P-sorawit/Circuit-Project-Smart-Home-/Report.pdf

Smart Home ปู้นปู้นเวรี่ย

์ปู้นปู้นสลดิปิ้ดปั๊ด

โดย

นายภัทรวิน ยอดสุขา รหัสนักศึกษา 67010699

นายภาคิน โพธิจรรยากุล รหัสนักศึกษา 67010705 นายวิริทธิ์พลรอดเงิน รหัสนักศึกษา 67010848

นายสรวิศ เพชรพบิูลย์ไทย รหัสนักศึกษา 67010926

รายงานฉบับนี้เป็ นส่วนหนึ่งของการศึกษาในรายวิชา 01076107 Circuits and Electronicsและ01076108 Circuits and Electronics in Practice สาขาวิศวกรรมคอมพิวเตอร์ ภาควิชาวิศวกรรมคอมพิวเตอร์ คณะวิศวกรรมศาสตร์
สถาบันเทคโนโลยีพระจอมเกล้าเจ้าคุณทหารลาดกระบัง ปี การศึกษา 2567

### บทที่1 บทน า และหลักการ

### 1.1 แนวคิดและที่มาของปัญหา

ปัจจุบันเทคโนโลยีมีการพัฒนาอย่างรวดเร็ว ส่งผลให้เทคโนโลยีสมาร์ทโฮมหรือบ้านอัจฉริยะได้รับ ความนิยมมากข้ึน เนื่องจากสามารถเพิ่มความสะดวกสบายและสร้างการใช้พลังงานอย่างมีประสิทธิภาพ หนึ่ง ในปัญหาหลักที่พบคือ การที่ไม่สามารถตรวจสอบอุปกรณ์เครื่องใชไ้ฟฟ้าภายในบา้นวา่ ใชง้านอยู่หรือไม่อีกท้งั การจอดรถในพ้ืนที่โรงรถ ที่มีพ้ืนที่จา กัดอาจทา ให้เกิดอุบตัิเหตุ เช่น การเฉี่ยวชนก าแพง สุดท้ายปัญหาการ จัดการอุณหภูมิภายในบ้านที่ต้องมีการระบายความร้อนเมื่ออุณหภูมิสูงเกินไปอย่างมีประสิทธิภาพ
โครงงาน "โมเดลจ าลองบ้านอัจฉริยะ" จึงถูกพฒั นาข้ึนเพื่อน าเสนอแนวทางในการแก้ไขปัญหา เหล่าน้ีโดยการบูรณาการเทคโนโลยีและระบบอัตโนมัติเข้ากับบ้านพกัอาศัยเพื่อเพิ่มความสะดวกสบาย ความปลอดภัย และความประหยัดพลังงาน โดยมีฟังก์ชันการท างานหลัก คือการควบคุมการเปิ ด-ปิดไฟร้ัวบา้น ด้วยรีโมท ระบบไฟที่เปิดปิดไฟร้ัวบา้นตามความเขม้แสงของสภาพแวดลอ้ มบา้น ระบบแจ้งเตือนใกล้ชนในที่ จอดรถการใช้เซ็นเซอร์วัดอุณหภูมิภายในบ้านเพื่อระบายความร้อนโดยพัดลม และระบบการแตะแผ่นเซ็นเซอร์ เพื่อเปิ ดไฟภายในบ้าน ซึ่งหลักการที่เกี่ยวข้องกับการสร้างโมดูลต่างๆในวงจรคือวงจรขยายสัญญาณและวงจร เปรียบเทียบ เพื่อเพิ่มขนาดของแรงดนัและเปรียบเทียบแรงดัน เพื่อให้สัญญาณจากเซ็นเซอร์สามารถอ่านค่าได้ ง่ายข้ึน โดยมีการใช้ออปแอมป์ เป็ นอุปกรณ์หลักในการสร้าง ดังต่อไปน้ีโมดูลเซ็นเซอร์วัดอุณหภูมิโมดูล วัดแสง(LDR) โมดูล Touch SensorโมดูลIR Remote และโมดูล IR Detect Car ผลลัพธ์จากโครงงานน้ีจะสามารถช่วยเพิ่มประสิทธิภาพในการบริหารจดัการบา้น ลดการใช้พลังงาน อย่างไม่จ าเป็ น เพิ่มความปลอดภยั และอา นวยความสะดวกให้แก่ผใู้ชง้านไดด้ีและเป็ นแบบอย่างต้นแบบให้กับ ผู้ที่สนใจเทคโนโลยีบ้านอัจฉริยะได้น าไปเป็ นแบบอย่างศึกษาต่อได้

### 1.2 วัตถุประสงค

์
1. เพื่อออกแบบและพัฒนาเซ็นเซอร์วัดอุณหภูมิโดยอัตโนมัติ
2. เพื่อออกแบบและพฒั นาเซ็นเซอร์วดัแสงเพื่อเปิดไฟร้ัวบา้นโดยอตัโนมตัิ
3. เพื่อออกแบบและพัฒนาเซ็นเซอร์ตรวจจับรถในโรงรถโดยอัตโนมัติ
4. เพื่อออกแบบและพัฒนา Touch Sensor ใช้ในการเปิ ดไฟ
5. เพื่อออกแบบและพัฒนารีโมทส่งคลื่น Infrared
6. เพื่อเป็ นต้นแบบของการพัฒนาบ้านอัจฉริยะ

### 1.3 หลักการท างานของโครงงาน

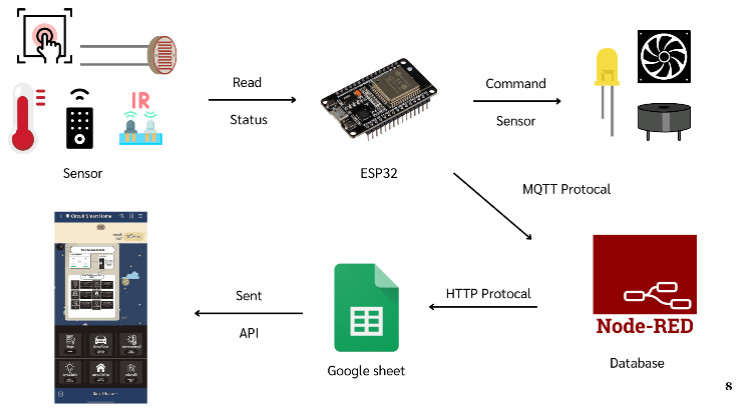
[picture p1: figure]

รูปที่ 1.1 แสดงภาพรวมการท างานของวงจร โครงงานประกอบไปด้วยเซ็นเซอร์ที่ท าหน้าที่เป็ น Input ท้งัหมด 5 ตวั ไดแ้ก่ LDR, Touch sensor, NTC Thermistor, IR Receiver (จากรีโมท)และIR Receiver (จากโรงรถ) มี Output 3 ชนิด ไดแ้ก่ หลอด LED, พัดลม และBuzzer โดย เมื่อแรงดันไฟฟ้ าผ่านวงจรเปรียบเทียบและวงจรขยายสัญญาณของ Op-Amp จะสั่งงาน เปิ ดพัดลมและหลอด LED โดยอัตโนมัติ เมื่อ ESP32อ่านค่าเซ็นเซอร์ที่รับมา จะพิจารณาสั่งการเปิด/ปิดไฟ และ Buzzer จากน้ันจะส่งขอ้ มูลค่า Input ที่อ่านได้ไปยัง Node-Red (เป็ น Protocol ตัวกลางส่งข้อมูลระหว่าง Node-Red กับ Google Sheet) ด้วย MQTT Protocol เมื่อ Node-Red ได้รับค่าจาก ESP32จะผ่านฟังก์ชันเปลี่ยนค่าที่ได้ รับมาให้เป็ นตัวแปรที่เหมาะสมต่อการแสดงผลบน Google Sheet จากน้ันเมื่อผูใ้ช้ตอ้งการทราบค่าเซ็นเซอร์ ต่างๆในบา้นโดยการกดขอขอ้ มูลในไลน์บอท ที่มีบอทน้อยทา งานอยู่เบ้ืองหลงั บอทน้อยจะส่ง APIขอข้อมูล จาก Google Sheet เพื่อรับค่าเซ็นเซอร์มาแสดงผลให้กับผู้ใช้งาน ซึ่งFunction ในไลน์บอทประกอบไปด้วย การ ส่งอข้อมูลสรุปผลการอ่านค่าเซ็นเซอร์แบบตลอดเวลา, การส่งสถานะที่จอดรถปัจจุบันในบ้าน, การส่งค่า อุณหภูมิเฉลี่ยปัจจุบันภายในบ้าน, การส่งสถานะปัจจุบนั ไฟร้ัวบา้น, การส่งสถานะปัจจุบันไฟภายในบ้านและ การส่งวิธีการใช้งานไลน์บอท

### บทที่ 2 การออกแบบโครงงาน และการวิเคราะห์วงจร

### 2.1. การออกแบบโครงงาน

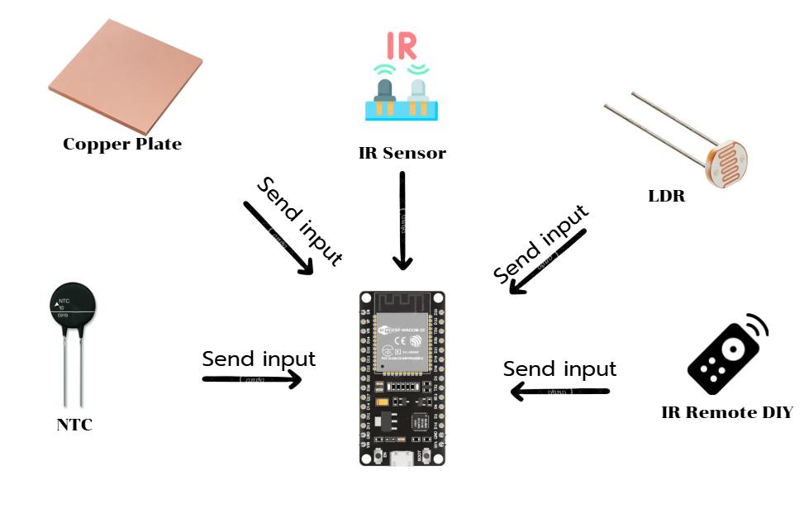
[picture p2: figure]

รูปที่ 2.1แสดงรายละเอียดอุปกรณ์Input

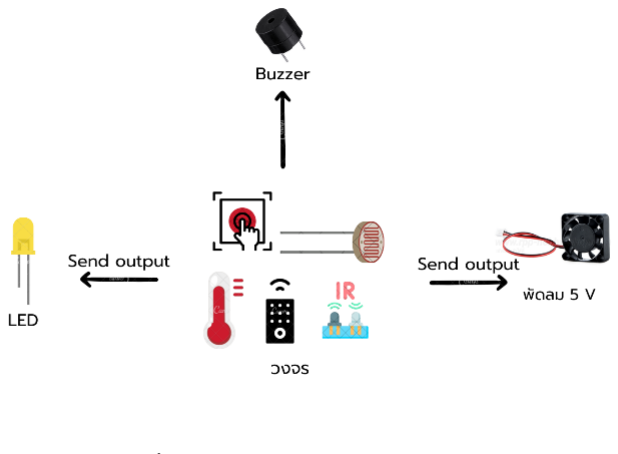
[picture p3: figure]

รูปที่ 2.2แสดงรายละเอียดอุปกรณ์output

### 2.1.1. วงจรวัดอุณหภูมิ

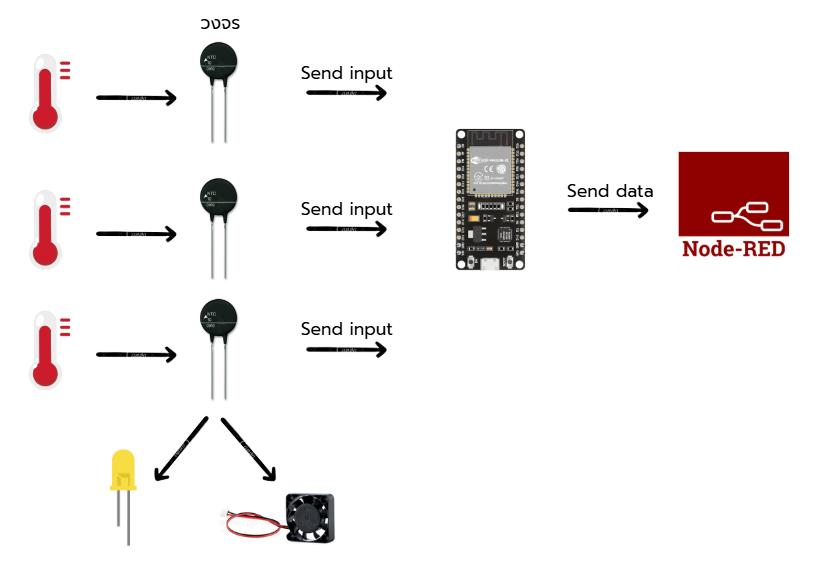
[picture p4: figure]

รูปที่ 2.3แสดงการออกแบบวงจรวัดอุณหภูมิ

หลักการท างานของวงจรวัดอุณหภูมิคือ NTC วัดอุณหภูมิ และส่งค่าให้กลับ ESP32และ ESP32 ส่งอุณหภูมิที่วัดได้ไป Node-RED เพื่อจะส่งไปยัง Google sheet ต่อไป ส่วนวงจร NTC แต่ละตัวเมื่ออุณภูมิท า ให้ค่าแรงดันที่ขา IN+ มากกว่าแรงดันที่ขา IN- จะท าให้LED ในวงจรน้นั ติดเพื่อเป็นสัญญาณแสดงว่าอุณหภูมิ ณ จุดน้นั ร้อนเกิน 30 องศาและเมื่อมีจุดที่ร้อนมากกว่า2จุดจะท าให้พัดลมติดและไฟติดเพื่อเป็ นสัญญาณว่าพัด ลมก าลังเปิ ดอยู่

### 2.1.2. วงจรIR Remote

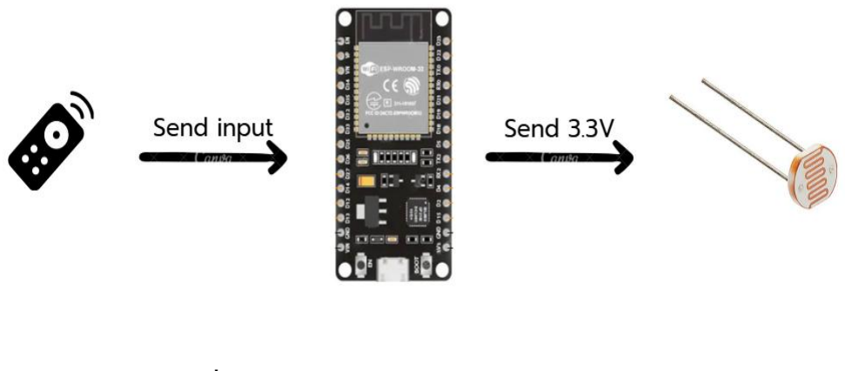
[picture p5: figure]

รูปที่ 2.4แสดงการออกแบบวงจร IR Remote

หลักการท างานของวงจร IR Remoteคือ เมื่อได้รับสัญญาณ Infraredจะท าให้แรงดันที่ตกคล่อมที่ ขา IN+ มากกว่าแรงดันที่ขา IN-จะส่งข้อมูลให้ESP32 (https://www.airwaveplus.com/product/InfLED-850nm) เพื่อส่งจ่ายไฟ 3.3 V ให้LDR

### 2.1.3. วงจรวัดความเข้มแสง

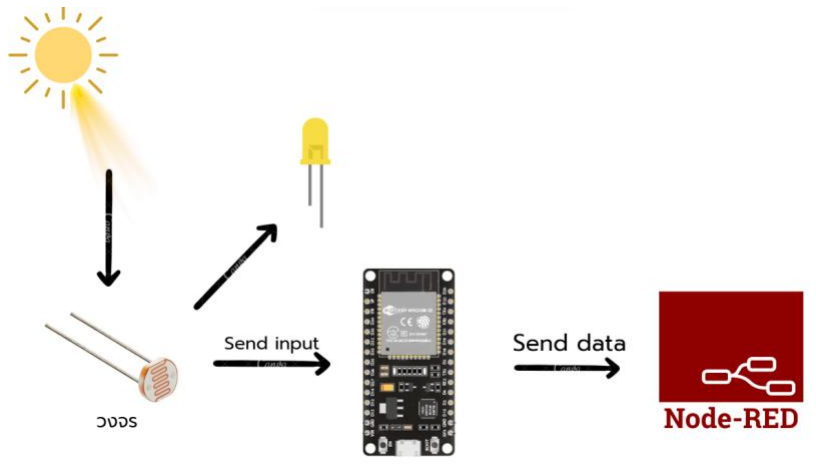
[picture p6: figure]

รูปที่ 2.5แสดงการออกแบบวงจรวัดความเข้มแสง

หลักการท างานของวงจรวัดความเข้มแสง เมื่อมีการจ่ายไฟ 3.3 V จาก ESP32 จะท าให้วงจร LDR ท างาน แล้วจะ มีไฟ LED 1 ดวงติดเพื่อแสดงว่า LDR ก าลังท างานอยู่ และเมื่อค่าแสงที่วัดได้ท าให้แรงดันที่ตกคล่อมที่ขา IN+ มากกว่าแรงดันที่ ขา IN-จะท า ให้ไฟ LED ที่ร้ัวติดเลว้ส่งขอ้ มูลไปให้ESP32 เพื่อส่งให้Node-RED และ Google sheetแต่ถ้าไม่ได้จ่ายไฟ 3.3 V ให้วงจรจะท าให้ไฟ LED แสดงสถานะไม่ได้ใช้งานติด

### 2.1.4. วงจรIR Sensor

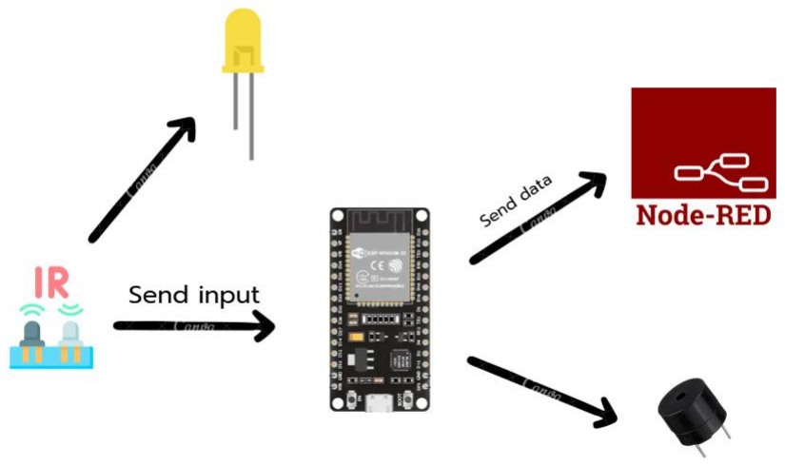
[picture p7: figure]

รูปที่ 2.6แสดงการออกแบบวงจร IR Sensor

หลักการท างานของวงจร IR Remoteคือ เมื่อไม่ได้รับสัญญาณ Infrared จะท าให้ แรงดันที่ตกคล่อมที่ ขา IN+ น้อยกว่าแรงดันที่ขา IN- จะท าให้ไฟ LED ติดเพื่อแสดงสถานะว่ามีรถขวางอยู่ และจะส่งเข้า ESP32 เพื่อให้ส่งไปยัง Node-RED และ Google sheet และ ESP32จะท าให้Buzzer ติด

### 2.1.5. วงจร Touch Sensor

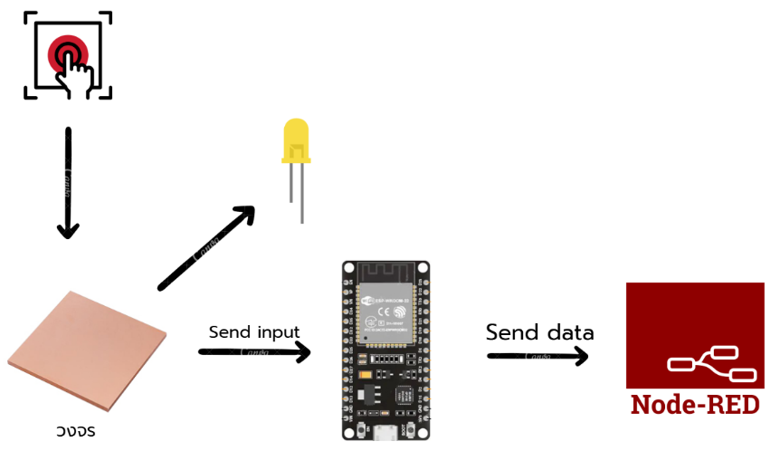
[picture p8: figure]

รูปที่ 2.7แสดงการออกแบบวงจร Touch Sensor

หลักการท างานของวงจร Touch sensorคือ เมื่อมีการถ่ายเทประจุผ่านการสัมผัสที่แผ่นทองแดงจะ ท าให้แรงดันที่ตกคล่อมขา IN+ มากกว่าแรงดันที่ขา IN-และจะท าให้ไฟ LED ติด และยังมีการส่งข้อมูล ไปยัง ESP32และ ESP32 ส่งสถานะของไฟLEDไป Node-RED เพื่อจะส่งไปยัง Google sheet ต่อไป

### 2.2 การวิเคราะห์วงจร

### 2.2.1. วงจรวัดอุณหภูมิ

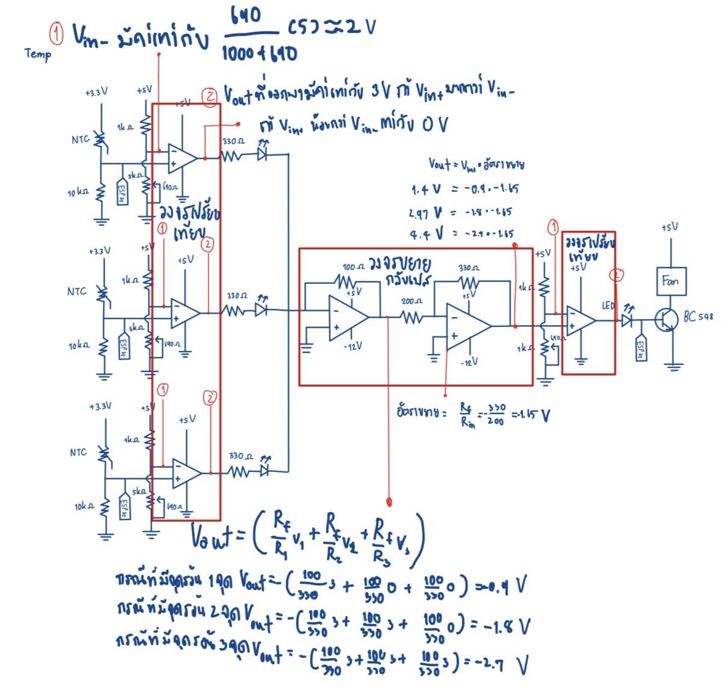
[picture p9: figure]

รูปที่ 2.8แสดงการวิเคราะห์วงจรวัดอุณหภูมิ (รูป 2.3)

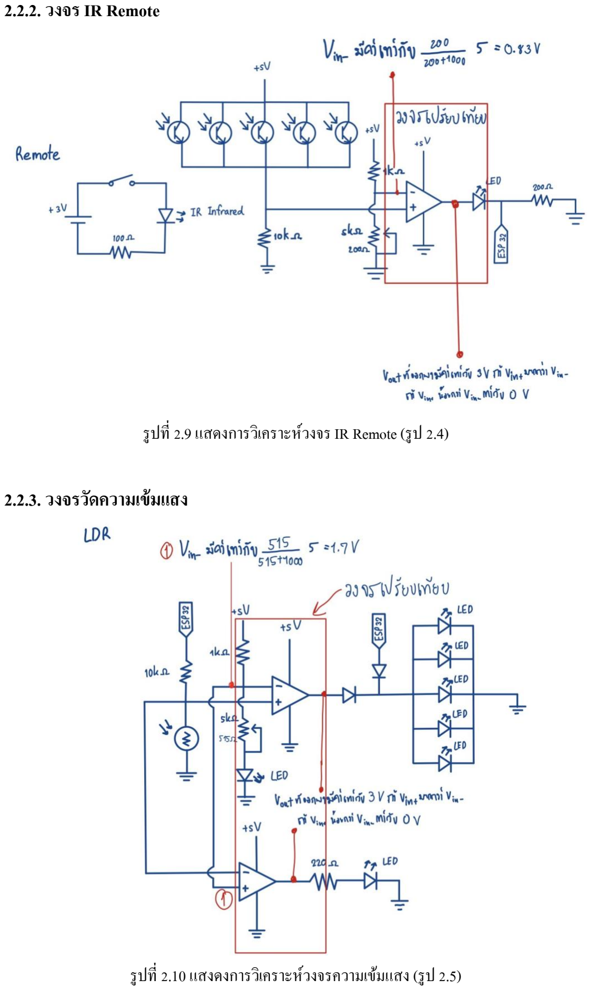
[picture p10: page 9]

### 2.2.2. วงจร IR Remote

รูปที่ 2.9แสดงการวิเคราะห์วงจร IR Remote (รูป 2.4)

### 2.2.3. วงจรวัดความเข้มแสง

รูปที่ 2.10แสงดงการวิเคราะห์วงจรความเข้มแสง (รูป 2.5)

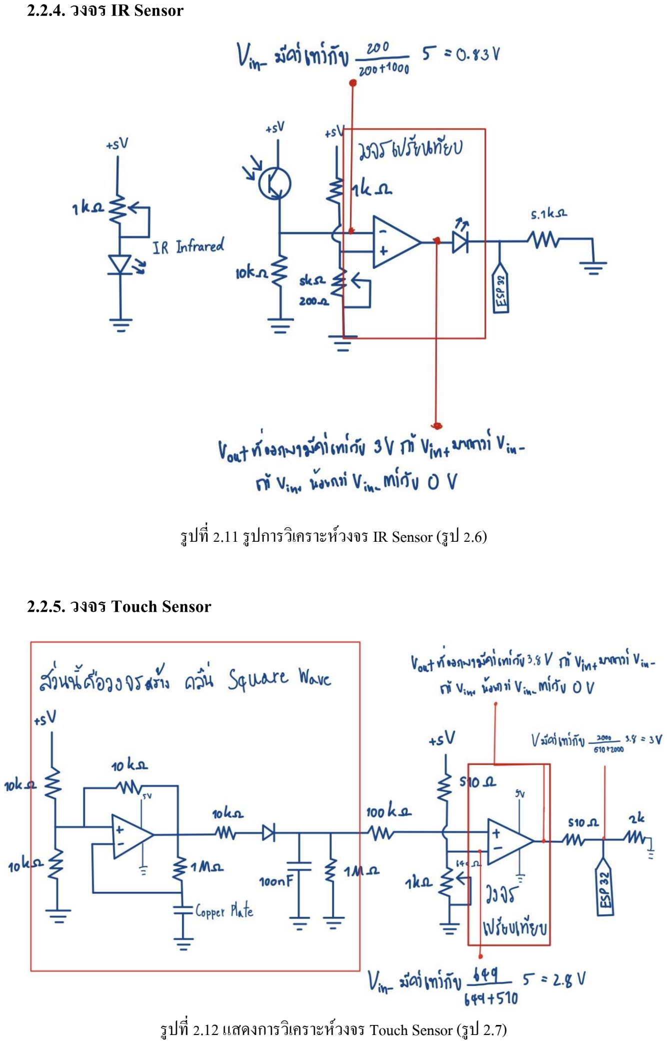
[picture p11: page 10]

### 2.2.4. วงจรIR Sensor

รูปที่ 2.11รูปการวิเคราะห์วงจร IR Sensor (รูป 2.6)

### 2.2.5. วงจร Touch Sensor

รูปที่ 2.12แสดงการวิเคราะห์วงจร Touch Sensor (รูป 2.7)

### บทที่ 3

### ผลการทดลองและการสรุปผลโครงงาน

### 3.1. ผลการทดลอง

### 3.1.1. วงจรวัดอุณหภูมิ

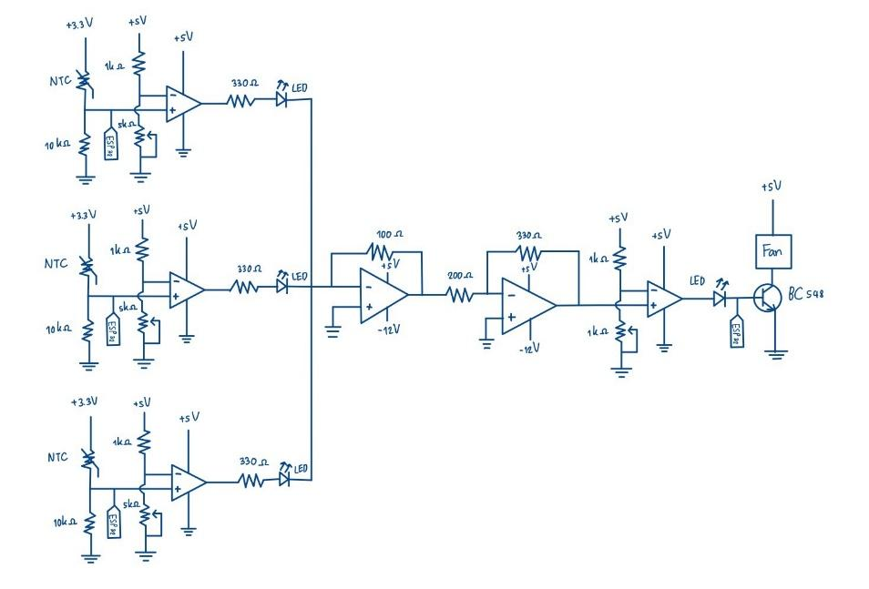
[picture p12: figure]

รูปที่ 3.1แสดงวงจรของวงจรวัดอุณหภูมิ

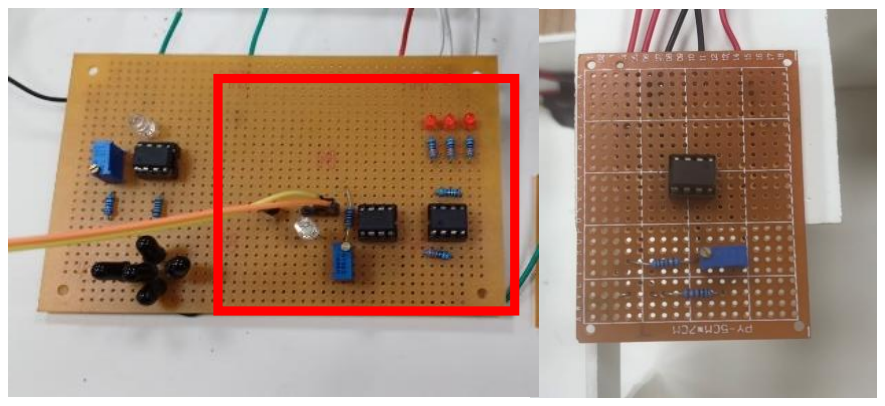
[picture p13: figure]

รูปที่ 3.2 แสดงอุปกรณ์ของวงจรวัดอุณหภูมิ

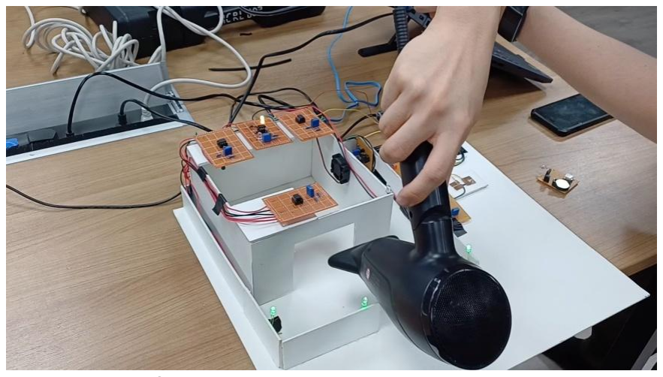
[picture p14: figure]

รูปที่ 3.3แสดงการทดลองใช้เซ็นเซอร์วัดอุณหภูมิ

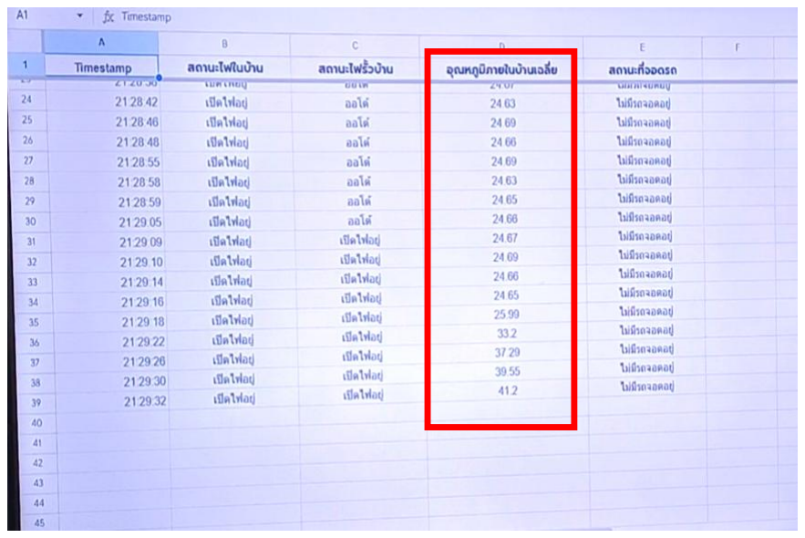
[picture p15: figure]

รูปที่ 3.4. แสดง Google Sheet

ระบบน้ีใช้เซ็นเซอร์วัดอุณหภูมิ 3 จุด ภายในบา้น และทา งานผา่ นกระบวนการวิเคราะห์ดงัน้ี:
1. วงจรวัดอุณหภูมิ–ใช้วงจรเซ็นเซอร์วัดอุณหภูมิ 3 วงจรจากน้นัค่าที่ได้จากแต่ละเซ็นเซอร์จะ ถูกส่งไปยัง ESP32 และ วงจรเปรียบเทียบแรงดัน เพื่อพิจารณาวา่ ตา แหน่งน้นั มีอุณหภูมิสูงกวา่ ค่าที่ ก าหนดหรือไม่

2. วงจรรวมสัญญาณ - จะน าค่าผลลพัธ์จากวงจรเปรียบเทียบแรงดนัของท้งั 3 จุดจะถูกส่งมา รวมที่วงจรรวมสัญญาณ หากพบว่า 2 ใน 3 จุด มีอุณหภูมิสูง ระบบจะส่งสัญญาณไปยังวงจร เปรียบเทียบแรงดนัอีกคร้ังเพื่อยนืยนัความจา เป็นในการเปิดพดัลม
3.วงจรควบคุมพัดลมและแสดงผลผ่าน LED - หากตรวจพบว่า 2 ใน 3 จุดมีอุณหภูมิสูงเกินค่าที่ ก าหนด ระบบจะสั่งใหพ้ ดัลมเปิดทา งานอตัโนมตัิและจะแสดงสถานะของอุณหภูมิโดยรวมและการ ท างานของพัดลมจะแสดงผ่าน หลอด LED และสามารถตรวจสอบผ่าน บอทน้อย

3.1.2.วงจรIR-Remote

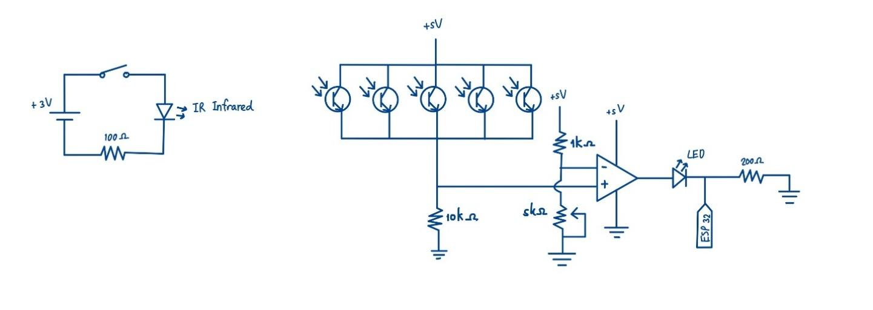
[picture p16: figure]

รูปที่3.5 แสดงวงจรIR Remote

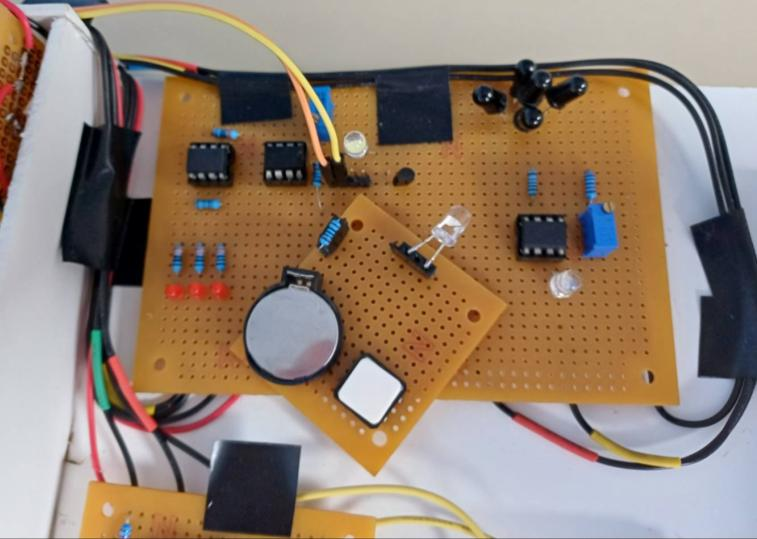
[picture p17: figure]

รูปที่3.6 แสดงอุปกรณ์ของวงจรIR Remote

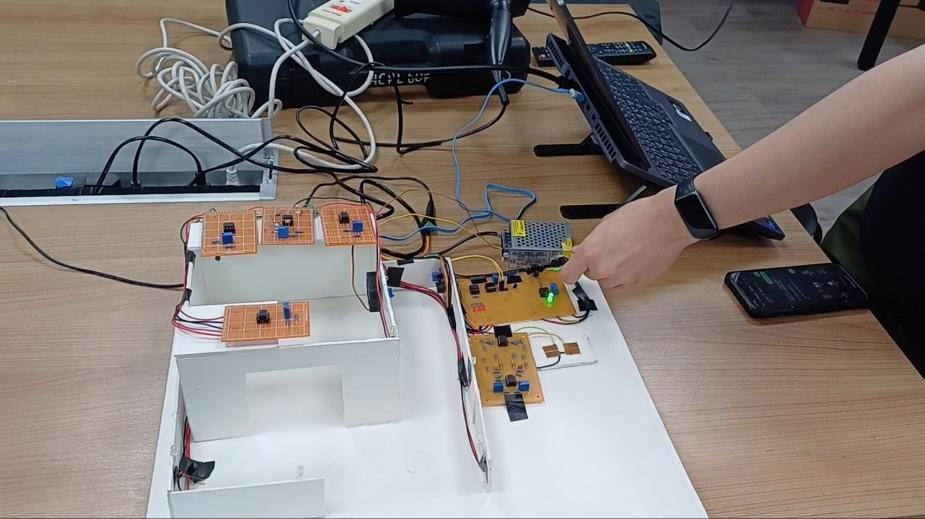
[picture p18: figure]

รูปที่3.7 แสดงการทดลองใช้วงจรIR-Remote

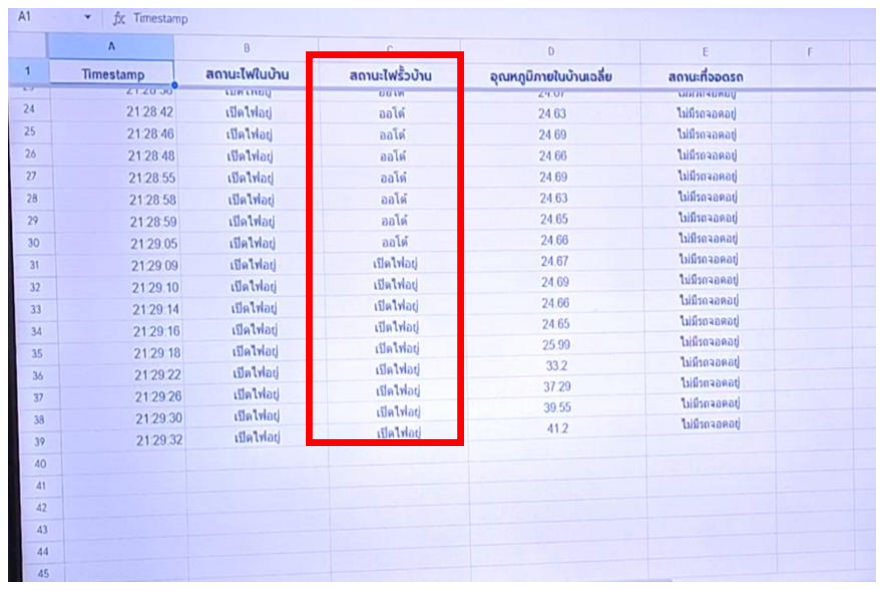
[picture p19: figure]

รูปที่3.8 แสดง Google Sheet

วงจรIR-Remote สา หรับควบคุมไฟร้ัวบา้นสามารถทา งานไดใ้น 2โหมดหลัก ดงัน้ี:
1.โหมด Auto – สามารถสั่งให้ไฟเปิดหรือปิ ดได้โดย LDR ที่สั่งการโดยอตัโนมตัิเมื่อได้รับ สัญญาณ
2.โหมด Manual - สามารถสั่งให้ไฟเปิดหรือปิดร้ัวบา้นได้โดยการควบคุมจาก ESP32 เมื่อ ได้รับสัญญาณ

### 3.1.3. เซ็นเซอร์วัดความเข้มแสง

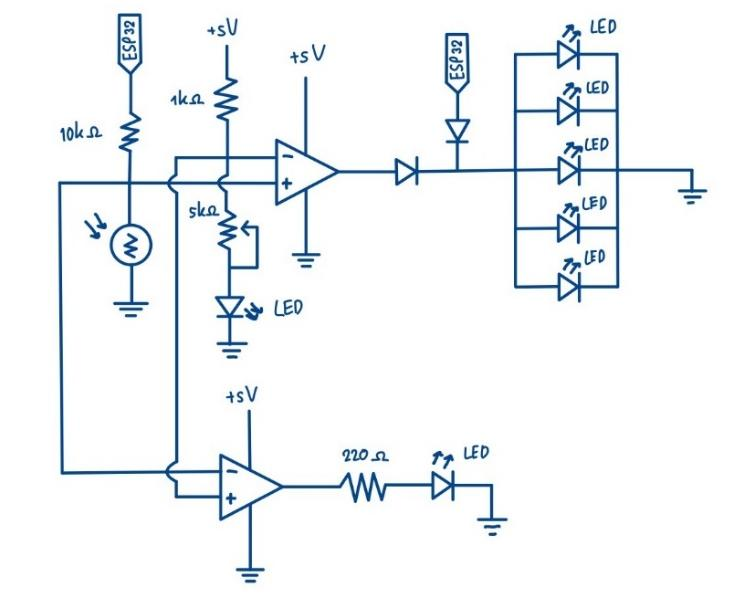
[picture p20: figure]

รูปที่ 3.9แสดงวงจรวัดความเข้มแสง

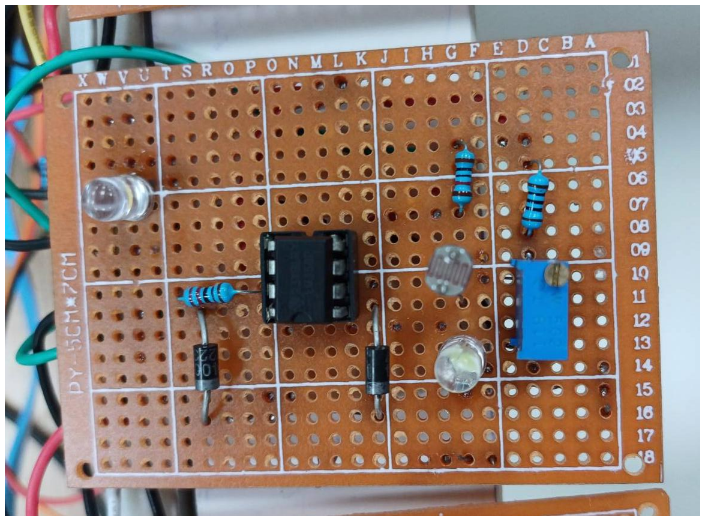
[picture p21: figure]

รูปที่ 3.10 แสดงอุปกรณ์ของวงจรวัดความเข้มแสง

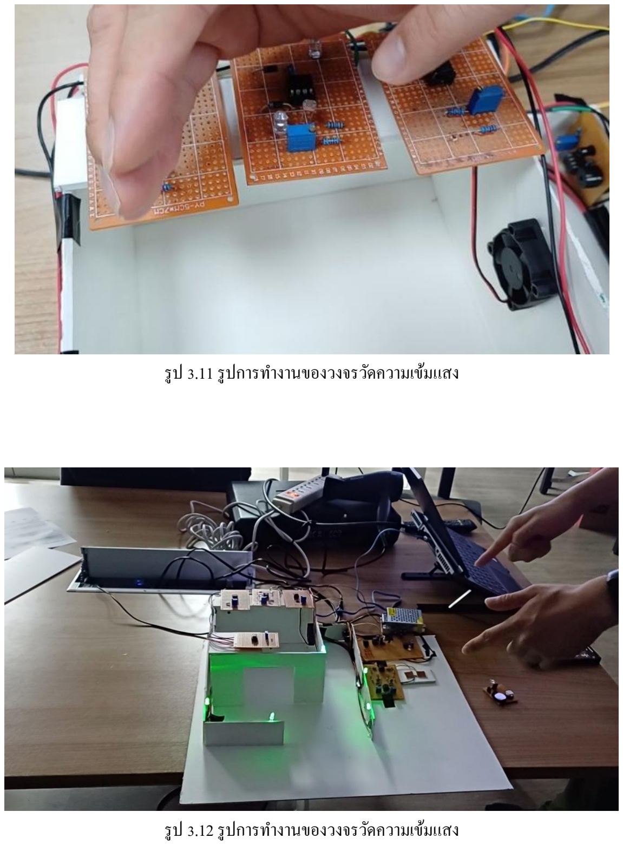
[picture p22: page 16]

รูป 3.11รูปการท างานของวงจรวัดความเข้มแสง

รูป 3.12รูปการท างานของวงจรวัดความเข้มแสง

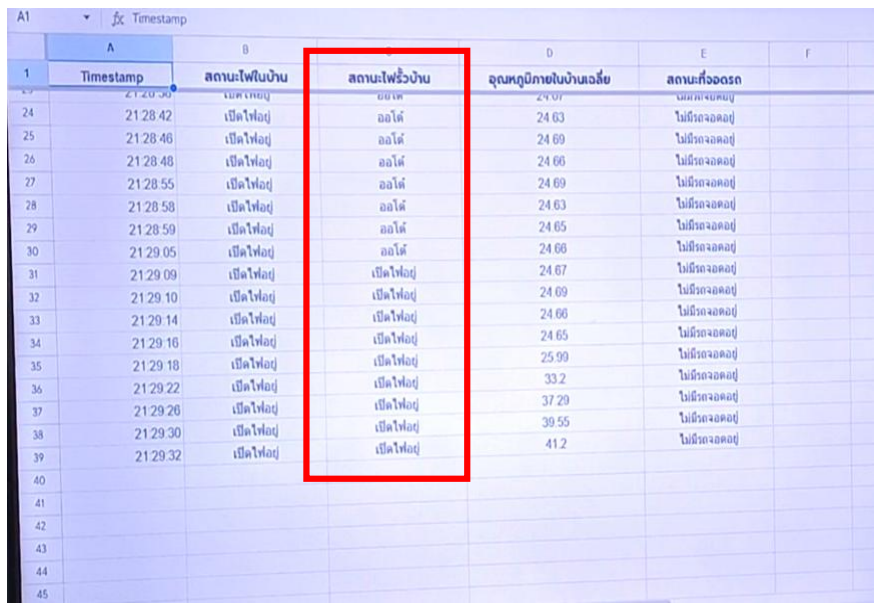
[picture p23: figure]

รูปที่ 3.13แสดง Google Sheet

วงจรตรวจวัดค่าความเข้มแสง (LDR Sensor) สา หรับควบคุมไฟร้ัวบา้นระบบสามารถทา งานไดใ้น 3 โหมดหลัก ดงัน้ี:
1. โหมดสั่งเปิดไฟ - สามารถสั่งใหไ้ฟเปิดไดโ้ดยตรงผา่ นการควบคุมจาก ESP32
2. โหมดสั่งปิดไฟ - สามารถสั่งใหไ้ฟปิดไดโ้ดยตรงผา่ นการควบคุมจาก ESP32
3. โหมดอัตโนมัติ - ระบบจะใช้เซ็นเซอร์ LDR ตรวจวัดค่าความเข้มแสงโดยรอบ จากน้นั สัญญาณที่ ได้จะถูกน าเข้าสู่วงจรเปรียบเทียบแรงดันเพื่อตรวจสอบว่าความสว่างลดลงถึงระดับที่ก าหนดหรือไม่ หาก ค่าความเขม้แสงต่า กวา่ ค่าที่กา หนด (เช่น เวลากลางคืนหรือมีแสงนอ้ย) ระบบจะสั่งให้ไฟเปิดโดยอตัโนมตัิ เมื่อค่าความเขม้แสงเพิ่มข้ึน (เช่น ในเวลากลางวนั )ระบบจะสั่งใหไ้ฟดบัโดยอตัโนมตัิ

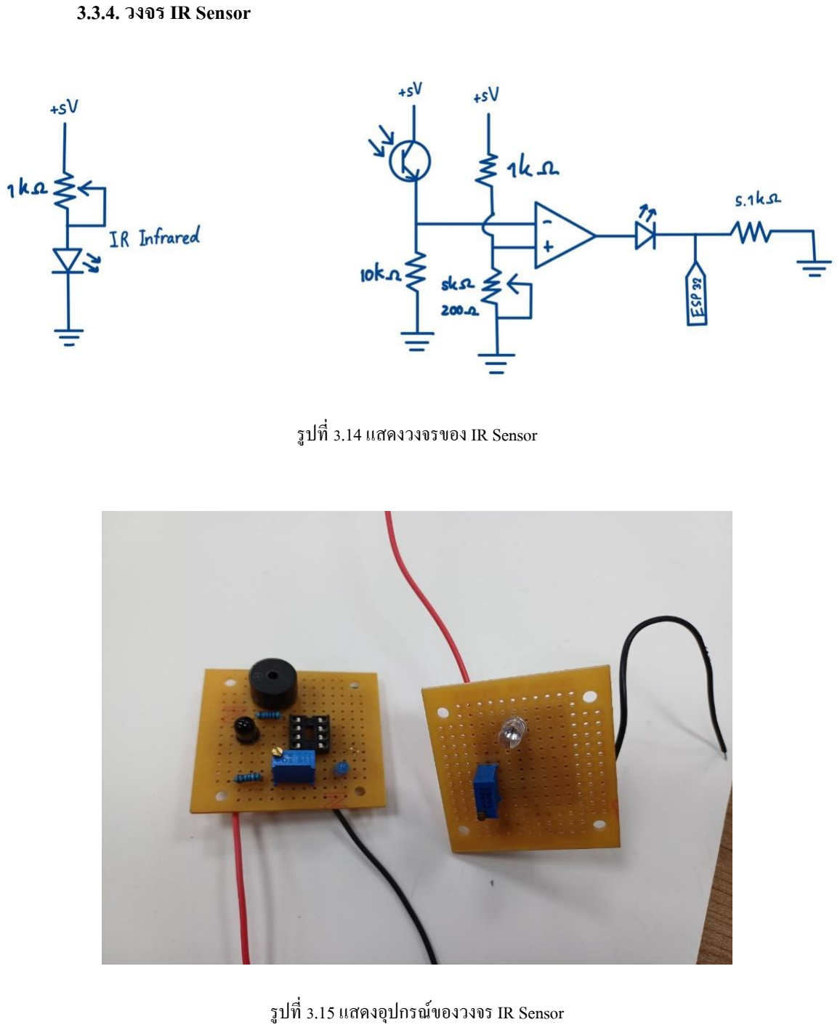
[picture p24: page 18]

### 3.3.4. วงจร IR Sensor

รูปที่ 3.14แสดงวงจรของ IR Sensor

รูปที่ 3.15แสดงอุปกรณ์ของวงจรIR Sensor

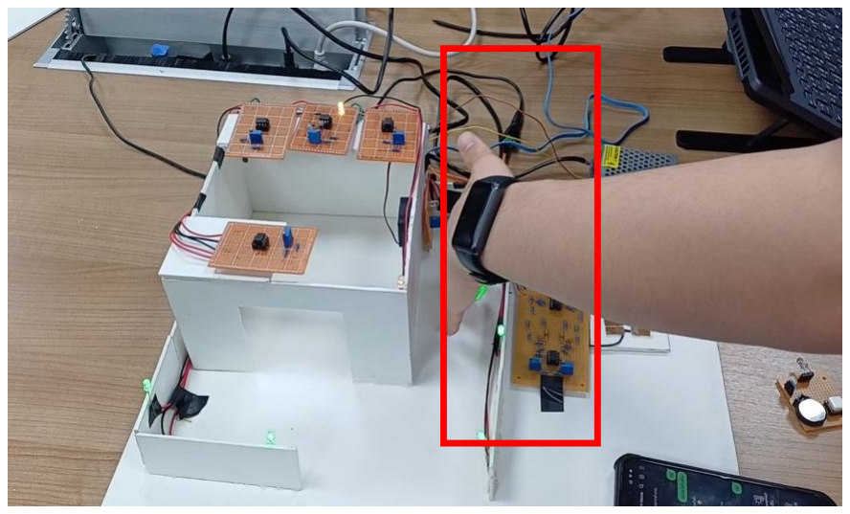
[picture p25: figure]

รูปที่ 3.16แสดงการทดลองการใช้IR Sensor

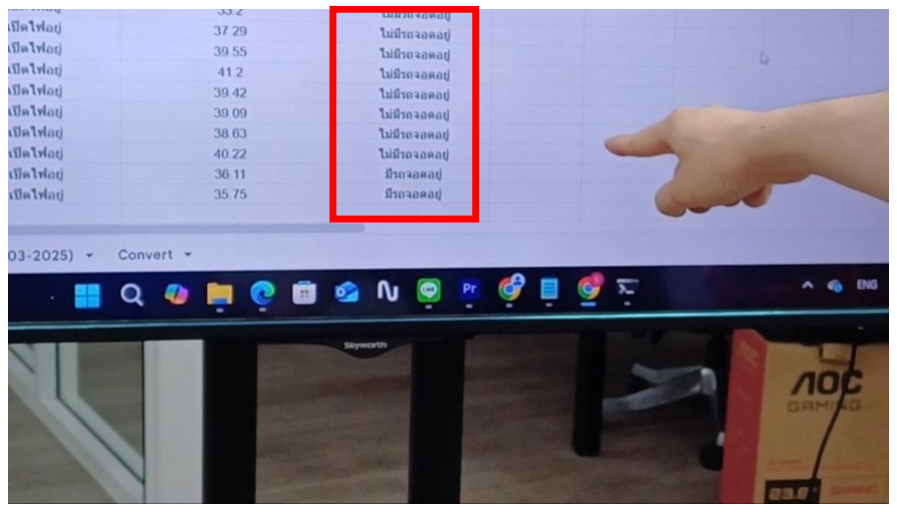
[picture p26: figure]

รูปที่ 3.17แสดง Google Sheet วงจรเซ็นเซอร์ตรวจจับสัญญาณอินฟาเรดประกอบด้วยวงจรตรวจจับแสงย่อย 2 วงจร ซึ่งสามารถ ตรวจจบั สัญญาณอินฟาเรดที่ไดร้ับมาได้จากน้นัค่าที่ตรวจจบัไดจ้ะถูกส่งต่อไปยงัวงจรเปรียบเทียบแรงดนั เพื่อ พิจารณาว่ามีสัญญาณอินฟาเรดหรือไม่ หากมีวัตถุกีดขวางที่สามารถบล็อกการรับสัญญาณอินฟาเรดได้ จะท าให้ Buzzer ท าการส่งเสียงเตือน

### 3.1.5. วงจร Touch Sensor

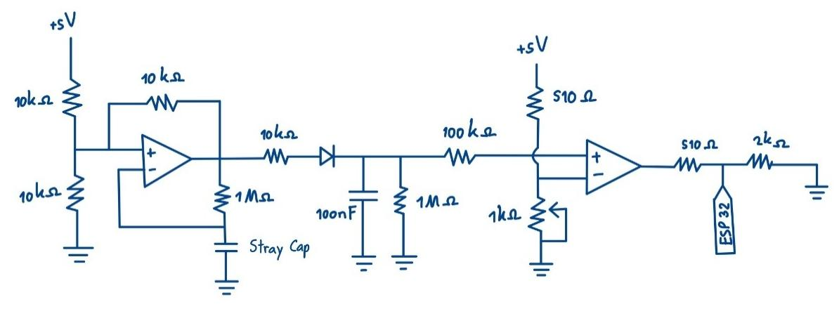
[picture p27: figure]

รูปที่ 3.18แสดงวงจรของวงจรTouch Sensor

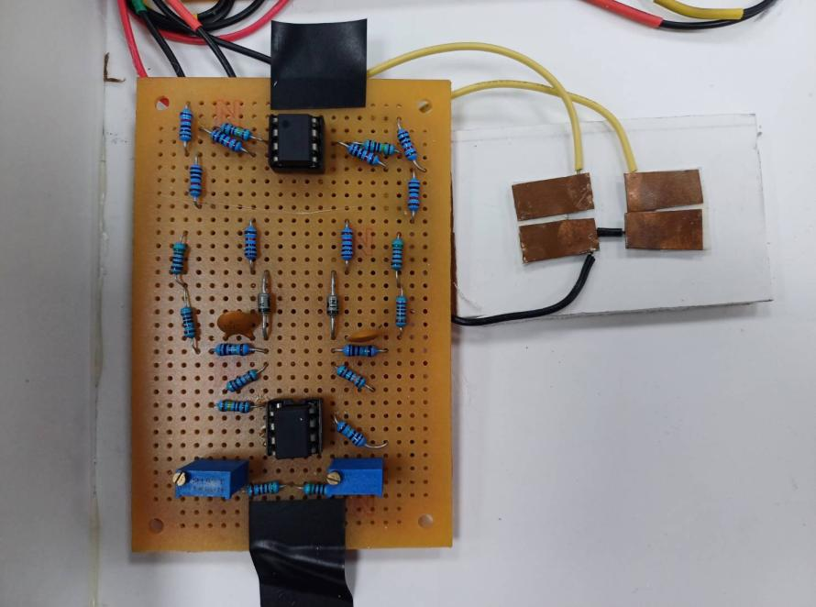
[picture p28: figure]

รูปที่ 3.19แสดงอุปกรณ์ของวงจร Touch Sensor

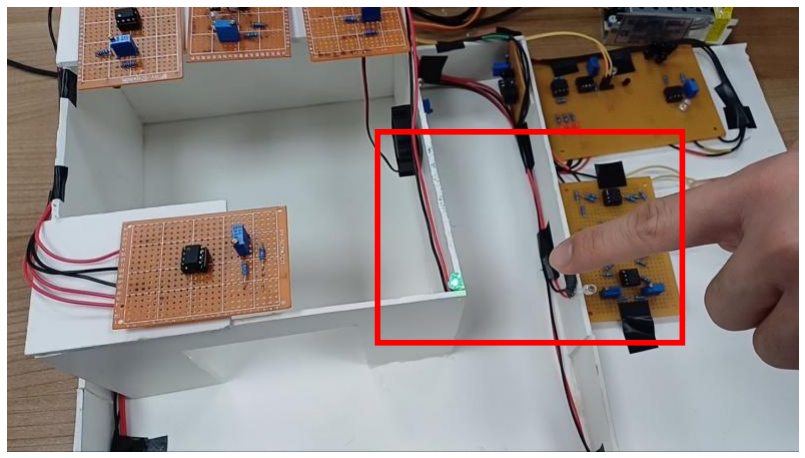
[picture p29: figure]

รูปที่ 3.20แสดงการทดลองการใช้วงจร Touch Sensor

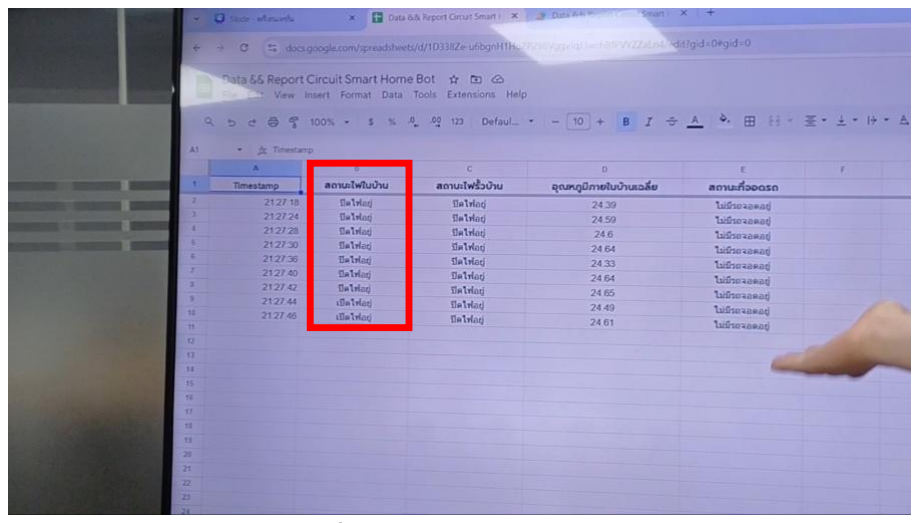
[picture p30: figure]

รูปที่ 3.21แสดง Google sheet

วงจรเซ็นเซอร์สัมผัสประกอบด้วยวงจรสร้างสัญญาณคลื่นสี่เหลี่ยม (Square wave) และวงจร เปรียบเทียบสัญญาณ เมื่อมีการสัมผัสที่แผ่นทองแดง จะเกิดการถ่ายโอนประจุระหว่างแผ่นทองแดงกับมือ ซึ่ง ส่งผลให้ความจุในวงจรเปลี่ยนแปลง ท าให้ไฟ LED ติดสว่างข้ึน และสามารถตรวจสอบสถานะการทา งานของ วงจรได้จากบอทน้อย

### 3.2 สรุปผลโครงงาน

โครงงาน Smart Home สามารถพัฒนาระบบบ้านอัจฉริ ยะที่ควบคุมผ่าน ESP32 และ Line Official Account ได้ส าเร็จ โดยสามารถ เปิ ด-ปิดไฟร้ัวบา้นอตัโนมตัิผา่ น LDR Sensor ควบคุมไฟภายในบ้านด้วย Touch Sensor ตรวจวัดอุณหภูมิผ่าน Thermistor Sensor และแจ้งเตือนการจอดรถผ่าน IR Sensor ด้วย Buzzerระบบจะ มีการส่งข้อมูลผ่าน MQTT และ HTTP Protocol ท าให้สามารถดูสถานะบ้านจากระยะไกลได้ซ่ึงโครงงานน้ียงั เป็ นโมเดลจ าลองส าหรับระบบบ้านอัจฉริยะให้กับผู้ที่สนใจเป็ นแบบอบ่างได้ศึกษาต่อ
การพฒั นาในอนาคตสามารถเพิ่ม AI และ Machine Learning ในการวิเคราะห์ข้อมูล, พัฒนาให้รองรับ ระบบสั่งงานด้วยเสียง และปรับปรุงระบบความปลอดภัย เพิ่มกล้องวงจรปิดภายในบ้านแล้วร่ายงานผล ตลอดเวลา

### โปสเตอร์

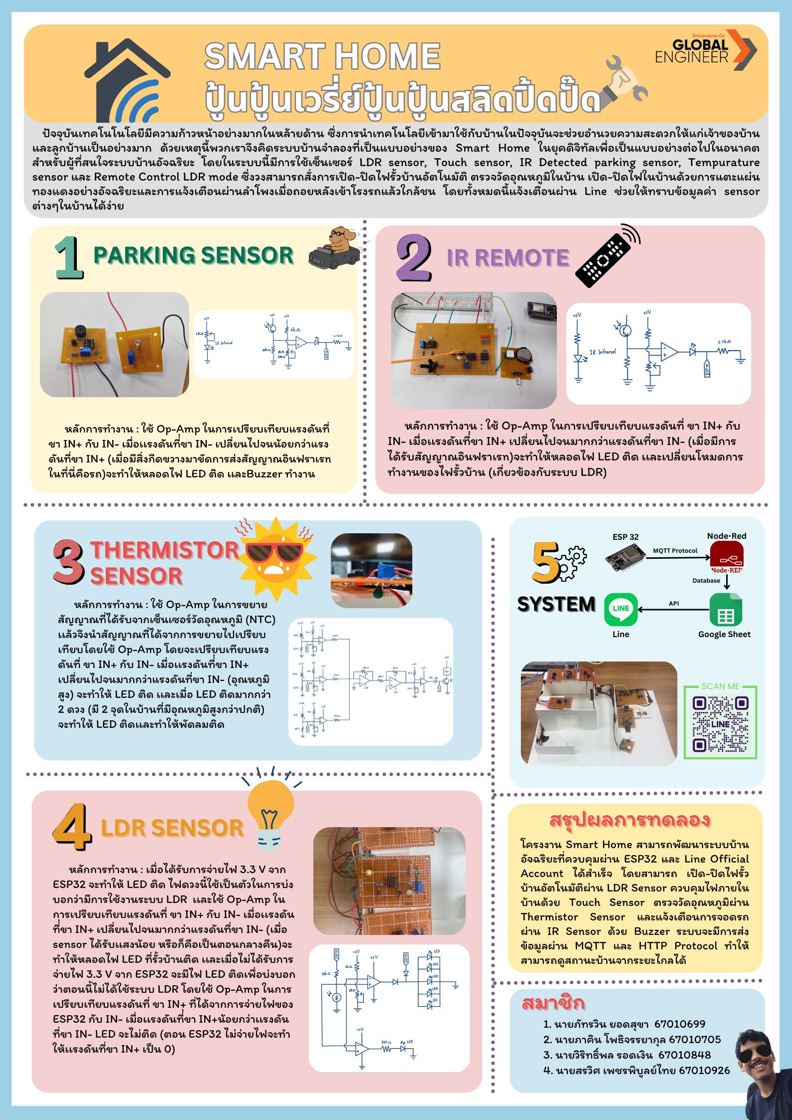
[picture p31: figure]

ตารางที่ 1รายการอุปกรณ์ที่ใช้สร้างโครงสร้างบ้านจ าลอง

ล าดับที่ | รายการอุปกรณ์ | จ านวน | ราคาต่อหน่วย | ราคารวม
1 | พลาสวูท 60x40 cm | 2 | 45.00 | 90.00
2 | ESP32 | 1 | 110.00 | 110.00
3 | แผน่ ปริ๊นไข่ปลา4*4.5 cm | 3 | 10.00 | 30.00
4 | แผน่ ปริ๊นไข่ปลา5*7 cm | 4 | 15.00 | 60.00
5 | แผน่ ปริ๊นไข่ปลา 9*15 cm | 1 | 25.00 | 25.00
ราคารวม | | | | 328.00
ตารางที่ 2รายการอุปกรณ์ที่ใช้กบัวงจรเปิดไฟร้ัวบ้านอจัฉริยะ(LDR Sensor)
ล าดับที่ | รายการอุปกรณ์ | จ านวน | ราคาต่อหน่วย | ราคารวม
1 | Op-amp LM358P | 1 | 12.00 | 12.00
2 | LDR 10K-0.5MΩ | 1 | 4.00 | 4.00
3 | Socket 8 pin | 2 | 5.00 | 10.00
4 | Diode 1N4004 | 2 | 3.00 | 6.00
5 | LED สีขาว | 1 | 3.00 | 3.00
6 | LED สีเขียว | 5 | 3.00 | 15.00
7 | LED สีWarm light | 1 | 3.00 | 3.00
8 | Resistor 220Ω | 1 | 1.50 | 1.50
9 | Resistor 1KΩ | 1 | 1.50 | 1.50
10 | Resistor 10KΩ | 1 | 1.50 | 1.50
11 | Resistor 100KΩ | 1 | 1.50 | 1.50
12 | Trimpot 5KΩ | 1 | 16.00 | 16.00
ราคารวม | | | | 75.00

ตารางที่ 3รายการอุปกรณ์ที่ใช้กบัวงจรระบายความร้อนของบ้าน (Temperature Sensor)

ล าดับที่ | รายการอุปกรณ์ | จ านวน | ราคาต่อหน่วย | ราคารวม
1 | พัดลมระบายความร้อน 5 v (3*3*1 cm) | 1 | 28.00 | 28.00
2 | Op-amp LM358P | 5 | 12.00 | 60.00
3 | Socket 8 pin | 5 | 5.00 | 25.00
4 | Transistor BC548 | 1 | 3.00 | 3.00
5 | LED สีขาว | 1 | 3.00 | 3.00
6 | LED สีแดง | 3 | 3.00 | 9.00
7 | NTC Thermistor 10 KΩ | 3 | 10.00 | 30.00
8 | Resistor 100Ω | 1 | 1.50 | 1.50
9 | Resistor 200KΩ | 1 | 1.50 | 1.50
10 | Resistor 330Ω | 4 | 1.50 | 6.00
11 | Resistor 1KΩ | 4 | 1.50 | 6.00
12 | Resistor 10KΩ | 3 | 1.50 | 4.50
13 | Trimpot 1KΩ | 1 | 15.00 | 15.00
14 | Trimpot 5KΩ | 3 | 16.00 | 48.00
ราคารวม | | | | 240.50
ตารางที่ 4รายการอุปกรณ์ที่ใช้กบัวงจรวัดระยะการถอยของรถ+การแจ้งเตือน (IR Sensor)
ล าดับที่ | รายการอุปกรณ์ | จ านวน | ราคาต่อหน่วย | ราคารวม
1 | Op-amp LM358P | 1 | 12.00 | 12.00
2 | Socket 8 pin | 1 | 5.00 | 5.00
3 | LED สีน้า เงิน | 1 | 3.00 | 3.00
4 | IR Infrared Transmitting 5mm 940nm | 1 | 5.00 | 5.00
5 | Phototransistor 5mm 940nm | 1 | 9.00 | 9.00
6 | Resistor 1KΩ | 1 | 1.50 | 1.50
7 | Resistor 5.1KΩ | 1 | 1.50 | 1.50
8 | Resistor 10KΩ | 1 | 1.50 | 1.50
9 | Trimpot 1KΩ | 1 | 15.00 | 15.00
10 | Trimpot 5KΩ | 1 | 16.00 | 16.00
11 | Buzzer (passive) | 1 | 7.00 | 7.00
ราคารวม | | | | 76.50

ตารางที่ 5รายการอุปกรณ์ที่ใช้กบัวงจรรีโมทควบคุมการเปลยี่ นโหมด (IR Remote)

ล าดับที่ | รายการอุปกรณ์ | จ านวน | ราคาต่อหน่วย | ราคารวม
1 | IR Infrared Transmitting 5mm 940nm | 1 | 5.00 | 5.00
2 | Phototransistor 5mm 940nm | 5 | 9.00 | 45.00
3 | Op-amp LM358P | 1 | 12.00 | 12.00
4 | Socket 8 pin | 1 | 5.00 | 5.00
4 | switch กดติดปล่อยดับ 4 ขา | 1 | 5.00 | 5.00
5 | ถ่านกระดุม CR2032 | 1 | 40.00 | 40.00
6 | รางถ่านกระดุม | 1 | 7.00 | 7.00
7 | LED สีเขียว | 1 | 3.00 | 3.00
6 | Resistor 100Ω | 1 | 1.50 | 1.50
7 | Resistor 200Ω | 1 | 1.50 | 1.50
8 | Resistor 1KΩ | 1 | 1.50 | 1.50
9 | Resistor 10KΩ | 1 | 1.50 | 1.50
10 | Trimpot 5KΩ | 1 | 16.00 | 16.00
ราคารวม | | | | 144.00
ตารางที่ 6รายการอุปกรณ์ที่ใช้กบัวงจรควบคุมการเปิดไฟในบ้าน (Touch Sensor)
ล าดับที่ | รายการอุปกรณ์ | จ านวน | ราคาต่อหน่วย | ราคารวม
1 | Op-amp LM358P | 2 | 12.00 | 24.00
2 | Socket 8 pin | 2 | 5.00 | 10.00
3 | Zener Diode 3.3V | 2 | 3.00 | 6.00
3 | LED 7สี กะพริบ | 1 | 4.00 | 4.00
3 | Resistor 510Ω | 4 | 1.50 | 6.00
4 | Resistor 2KΩ | 2 | 1.50 | 3.00
5 | Resistor 10KΩ | 8 | 1.50 | 12.00
6 | Resistor 100KΩ | 2 | 1.50 | 3.00
7 | Resistor 1MΩ | 4 | 1.50 | 6.00
8 | Trimpot 1KΩ | 2 | 15.00 | 30.00
9 | Capacitor Ceramic 100nF | 2 | 3.00 | 6.00
10 | แผ่นทองแดงบริสุทธิ์99.99% ขนาด 6x 6 cm | 1 | 22.00 | 22.00
ราคารวม | | | | 132.00

ตารางที่ 7ราคารวมทั้งโครงงาน

ล าดับที่ | รายการ | ราคา
1 | โครงสร้างบ้านจ าลอง | 315.00
2 | LDR Sensor | 75.00
3 | Temperature Sensor | 240.50
4 | IR Sensor | 76.50
5 | IR Remote | 144.00
6 | Touch Sensor | 132.00
ราคารวม | | 983.00
