P-sorawit/Circuit-Project-Smart-Home-/node_red_flow.png

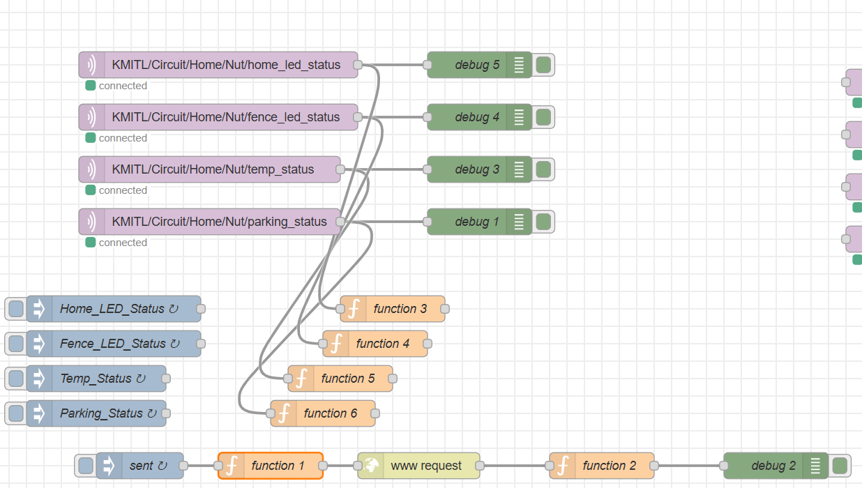
node_red_flow.png
